Juxi-Technology/SR-Support/firmware/sr_support_b_ptk/README.md

# sr_support_b_ptk — B 线固件（PTK7452MG，180° PWM）

> **完整步骤请按教程 [`../../tutorial/zh-hans/03-build-flash.md`](../../tutorial/zh-hans/03-build-flash.md) 及后续页**。

> **客户直接烧固件**：用 [`../releases/sr_support_b_ptk_factory.bin`](../releases/sr_support_b_ptk_factory.bin)
> 烧到 `0x0` 即可，无需 PlatformIO；本 README 其余部分面向开发者。

> 当前主固件。基于 Juxi-Technology/2dof-selfrighting-robot B 线固件（MIT/Apache-2.0），已改为 **PTK7452MG + 无源直连转接板**。
> 来源/许可：[`../../third_party/juxi-2dof/`](../../third_party/juxi-2dof/) · 教程 [`../../tutorial/zh-hans/11-reference.md`](../../tutorial/zh-hans/11-reference.md)  
> 状态：**已编译并烧录**（PlatformIO 6.2.0 + espressif32 8.0.0 + Arduino core 3.3.12；RAM 7.6%，Flash 13.0%；COM27 烧录 Hash verified）；**IMU 0x23 与两路舵机 bring-up 通过（`t` 自检）**；机械臂尚未组装，策略未跑。首次上电先手扶、空载、低电压。

## 1. 硬件假设

- ESP32-S3-DevKitC-1（或兼容板）。
- 转接板：**无源直连**，ESP32 GPIO → 3-pin 舵机排针；舵机 V+/GND 共用电源轨，排针可级联；**没有 PCA9685 / GPIO 扩展**。
- 2× PTK7452MG（180° PWM，无位置反馈；v0 只用 2 个，其余备用）。
- Juxi 6 轴 IMU（I²C 0x23、100 kHz、3.3V）。
- 舵机电源：**5V/≥5A**（本项目实机，四方向扶正已验证；PTK7452 额定 6V 约 3.4 kg·cm，更高电压仅作余量且只能接舵机电源轨）。
- ESP32 由同一 5V 电源经一分二供电（或 USB-C）；与舵机电源 **共地**；舵机电源端 1000–2200 µF。

## 2. 接线（示例，按转接板实际丝印确认）

| 器件 | 引脚 | 说明 |
|---|---|---|
| IMU SDA | GPIO6 | I²C 100 kHz；转接板 S6 信号脚 |
| IMU SCL | GPIO7 | I²C 100 kHz；转接板 S7 信号脚 |
| IMU VCC | ESP32 3V3 | 经转接板 S1 信号脚；**不要接舵机 V+（5V）** |
| IMU GND | ESP32 GND（直连） | 共地 |
| 肩舵机信号 | GPIO4 | 转接板 S4，50Hz PWM |
| 肘舵机信号 | GPIO5 | 转接板 S5，50Hz PWM |
| LED（可选） | GPIO2 | 状态灯 |
| 舵机 V+ | 5V/5A 电源 + | **不要接 ESP32 3V3** |
| 舵机 GND | 电源 − / ESP32 GND | 共地 |

> 转接板是级联方式：确认每个排针的 V+/GND/信号顺序一致，避免插反。

## 3. 编译/烧录

> **工具结论：PlatformIO（Arduino framework），不是 ESP-IDF。** 底层是 `esptool`，PlatformIO 会自动调用；不需要 `idf.py`。  
> 本机已装 Core 6.2.0 到项目内 `.venv`（与电脑端工具共用）；先激活 `.venv`，再直接用 `pio ...`；首次使用运行 `powershell -ExecutionPolicy Bypass -File tools/install_platformio.ps1` 安装。

PlatformIO（推荐）：

```bash
pio run -d firmware/sr_support_b_ptk -t upload
pio device monitor --rts 0 --dtr 0 -b 115200
```

Arduino IDE：

- 打开 `firmware/sr_support_b_ptk/src/main.cpp` 不是有效的 Arduino sketch；本目录是 PlatformIO 结构。  
- 如果必须用 Arduino IDE，新建 sketch，把 `src/*` 和 `include/*` 放到 sketch 目录，确保 `config.h` 在 include 路径；`config.h` 已定义 `ROBOT_PWM`，不需要额外 build flag。
- LEDC API 已兼容 Arduino-ESP32 2.x/3.x。

## 4. 串口命令（115200）

| 命令 | 作用 |
|---|---|
| `g` | 开始/继续运行策略（上电默认保持） |
| `s` | 停止策略，PWM 保持最后目标（不释放力矩） |
| `x` | 急停：detach PWM（舵机卸力）；之后需 `r` 重新初始化 |
| `r` | 重新初始化 PWM、回中位；再发 `g` |
| `c` | 重新校准陀螺 + **加速度计零点**（机器人须**站立在水平桌面**、保持静止）；加速度零点写入 NVS，重启自动加载。躺姿姿态倾斜不收敛时先做这一步 |
| `t` | 关节 ±0.5 rad 自检；结束后恢复原状态 |
| `1` / `2` | 手动：肩关节 +0.5 / −0.5 rad（保持，便于看方向） |
| `3` / `4` | 手动：肘关节 +0.5 / −0.5 rad |
| `0` | 手动：两关节回中位（仍为 manual 保持） |
| `m q1 q2` | 手动：任意目标角（rad，换行结束），例如 `m 1.55 -1.55` |
| `a` | **脚本自动扶正**：检测到倒地（`up_z<0.5` 持续 0.5 s）后执行实测序列，站起后回中保持；`s` 停止 |
| `v` / `b` | 运行时翻转肩 / 肘方向符号（校准用，重启恢复默认） |
| `i` / `j` | 运行时翻转 IMU X / Y 轴符号（之后发 `c` 重新校准陀螺） |
| `l` | 输出 3 s、50 Hz 快速日志（`F` 行：up/gyro/q/state/原始 IMU）；配合 `tools/hw_log.py` |
| `d` | **MuJoCo 实时镜像**：开关 50 Hz `T` 流（`T w x y z q1 q2`，姿态四元数 + 指令关节角）；配合 `tools/live_twin.py` |
| `o` / `p` | 肩关节 PWM 中位微调 ±10 µs（≈±0.9°，运行时，重启恢复）；`k` 读出当前中位 |
| `z` | **编码器式清零**：手动摆到目测中位后发送，当前姿态即成为两关节 q=0，并打印新中位值（不进 flash，确认后写回 `config.h`） |
| `e` | **电气中位**：两舵机直接输出 1520 µs（装舵盘前找中位用，与当前零点无关；之后发 `m 0 0` 退出） |

> `1`–`4`/`0`/`m` 进入 manual 模式，50 Hz 按 0.12 rad/步限速；`s`/`r`/`g` 都会退出 manual。
> IMU 固定 100 Hz 读取；主循环不再无节流读 I²C（否则读取失败、姿态冻结，策略会抖）。

每 250 ms 输出：

```
up ux uy uz | w wx wy wz | q q1 q2 | qd dq1 dq2 | run/hold/manual
```

> `s` 只是停止策略，舵机仍可能堵转发热；长时间异常请 `x` 或直接断舵机电源。  
> `x` 后舵机卸力，手臂会因重力落下；确认安全后再用。

### 4.1 MuJoCo 实时镜像（live twin）

`d` 打开的 `T` 流每 20 ms 一行：`T <qw> <qx> <qy> <qz> <q1> <q2>`（原始 IMU 坐标系四元数 + 指令关节角）。电脑端：

```
python tools/live_twin.py --port COM27
```

工具会自动发一次 `d`（若已在输出 `T` 行则不发），把实机姿态和手臂实时映射到 `robot_v1.xml` 模型窗口里；无 `T` 流时回退到 4 Hz 状态行或 `l` 快速日志（无四元数，航向由 up 向量最短弧重建，方向可能任意）。`--replay <日志文件>` 可离线回放。注意打开串口可能触发 ESP32 复位（DTR）。

### 4.2 零点标定（`z` 命令 + 方向键工具）

换齿、拆装或更换舵机后，按以下步骤重新定零（会把"手臂竖直"变成固件的 q=0）：

1. 电池 + Type-C 都接上，运行：

   ```
   python tools/hw_shoulder_range.py
   ```

2. 用**方向键**摆臂：`↑`/`↓` = 大臂 ±0.05 rad，`←`/`→` = 小臂 ±0.05 rad（Shift+方向键 = ±0.20），
   摆到目测正中竖直；
3. 按 `z`：当前姿态成为两关节的 q=0，固件打印新的中位值（肩/肘 µs）；`k` 可随时读取中位；
4. 把这两个 µs 写回 `config.h`（`SERVO_SHOULDER_CENTER_US` / `SERVO_CENTER_US`），并把
   `EXEC_REF*` 与 `getup_reference_b39.py` 的全部路点按同样的差值平移，重新烧录；
5. 复测四个方向。

> `z` 只改内存，重启即恢复；确认好用后必须按第 4 步固化，否则扶正序列的物理姿态会漂移。

### 4.3 WiFi 状态页与无线镜像

热点：SSID `SR-Support`，密码 `srsupport`，ESP32 地址 `192.168.4.1`（`w` 命令开关，默认开）。

**Twin 流开关**：状态页底部 `Twin ON/OFF` 按钮 = 串口 `d` 命令，MuJoCo 镜像无需串口：

```
python tools/live_twin.py --tcp <Robot IP>:3333
```

**配网（让 ESP32 加入家里的 WiFi）**：连上 `SR-Support` 热点后多数手机会自动弹出配网页
（热点门户）；没有弹出就手动打开 `http://192.168.4.1`，在 **Home WiFi** 卡片点 `Scan` →
选网络 → 填密码 → `Connect`。成功后：ESP32 以 AP+STA 双模同时留在热点和你家路由器上，
状态页显示它在家里的 **Robot IP**；凭据写入 NVS，重启自动重连。扶正执行期间拒绝配网
（扫描会短暂中断热点）。仅支持 2.4 GHz 网络。

- **浏览器状态页**：设备连上热点后打开 `http://192.168.4.1`，每 300 ms 刷新：状态
  （hold/getup/manual）、up 向量与直立度条、两关节指令角、扶正姿态/阶段/换向次数、运行时长。
  注意端口 80 是 HTTP；旧的 3333 是原始 TCP 遥测流，浏览器直接打开会超时。若浏览器设置了
  系统代理，请把 `192.168.4.1` 加入代理例外或临时关闭代理。
- **MuJoCo 无线实时镜像**：无需串口，`d` 打开 T 流后：

  ```
  python tools/live_twin.py --tcp 192.168.4.1:3333
  ```

  电脑需先连上 `SR-Support` 热点（此时电脑一般无外网，GitHub 等操作会失败，属正常）。
- 有线串口只在烧录/导出日志时需要；日常遥测、镜像、状态页都可以纯 WiFi。

> 加入外部路由器（STA 模式）未实现：需要配网与重连逻辑，当前 AP 方案已覆盖离线使用场景。

## 5. 策略（重要）

- `include/policy_b.h` 现在是 **v7（SR 慢接口）策略**（`training/b_line/models/ppo_selfrising_sr5/final.zip` 导出，5 维观测、目标增量 0.08 rad/step，10→128→128→2，Tanh），按估算质量 97.4 g、硬舵机模型（kp=50/kv=0.5）训练。
- 固件内置**站立收臂**：`up_z>0.95` 连续 0.2 s → 目标角以 0.12 rad/20 ms 归零（手臂竖直）并保持；`up_z<0.95` 暂停收臂，`<0.90` 交回策略重试。
- PTK7452 额定 6V 3.4 kg·cm（本项目 5V 实测可四方向扶正）；实机打印件称重后，用 [`../../training/b_line/`](../../training/b_line/) 重训并重新导出覆盖 `policy_b.h`。**当前版本按估算质量训练，实机成功率会低于仿真。**
- 观测/动作必须一致：10 维 `[up(3), gyro(3), q(2), qdot(2)]`；目标角 = action × 1.55 rad；每 20ms 最多变化 0.12 rad。

## 6. 上电顺序（建议）

1. 机器人放桌面，手臂大致竖直，周围 30 cm 无遮挡；手扶底座。
2. 只接 USB，确认 IMU 版本、陀螺校准、`ready; send g to run`。
3. 舵机上电（5V/5A），确认无异常电流/发热。
4. 发 `t` 自检，确认两个关节方向；方向反了改 `SERVO_SHOULDER_SIGN`/`SERVO_ELBOW_SIGN` 或重装舵盘。
5. 手扶机器人摆成倒地姿态，发 `g`；一有异常立即 `x` 或断舵机电源。
6. 成功后再逐步放手；记录成功率、电流、温度。

## 7. 旧骨架的去向

旧 8 路骨架固件 `sr_support_2dof/` 与两套 `reference_*` 示例已随 2026-11 仓库瘦身移除。
B 线只用 2 路 PWM（肩/肘），不需要 PCA9685；若以后要做 8 舵机机构，按 `src/servo_pwm.cpp`
的 LEDC 后端扩展即可。

## 8. 许可

- 固件基于 Juxi B 线代码（MIT/Apache-2.0）；保留 `third_party/juxi-2dof/` 的许可/来源。
- 不链接 Feetech SCServo（GPL-3.0）；B 线固件可按 MIT/Apache 使用。
- 硬件若使用 Juxi B 线 CAD/STL，属于 CERN-OHL-S-2.0；商用/分发前确认义务。
- 不使用 SelfRisingRobot 的代码/waypoint；`policy_b.h` 仅作基线，最终策略由本项目重训。
