Juxi-Technology/SR-Support/tutorial/zh-hans/01-hardware-and-bom.md

---
title: 01 硬件与物料
description: SR-Support 自扶正装置的整机参数、BOM、工具清单与供电安全要求。
---

# 01 硬件与物料

## 1.1 整机概览

SR-Support 是 2-DOF（肩 + 肘）主动自扶正装置：倒地后依靠手臂撑地、翻转和撬起，自主回到直立。

| 项目 | 参数 |
|---|---|
| 底座 | 8.5 × 8.5 cm 方形；总高 4 cm（3.7 cm 灰色升高座 + 3 mm 红色底板） |
| 手臂 | 直立高度约 26 cm（上臂 + 前臂） |
| 整机质量 | 约 102 g（含两舵机与电控，待逐件称重校准） |
| 肩关节 | PTK7452MG，可用行程约 [-1.07, +2.07] rad（舵盘换齿重新定零后） |
| 肘关节 | PTK7452MG，可用行程约 ±1.55 rad |
| 主控 | ESP32-S3-DevKitC-1（Arduino framework / PlatformIO） |
| 姿态 | Juxi ICM42670P 6 轴 IMU（I²C 地址 0x23，100 kHz） |
| 舵机驱动 | ESP32 LEDC，50 Hz，14 bit，脉宽 500–2500 µs |

## 1.2 BOM

| 类别 | 物料 | 数量 | 说明 |
|---|---|---|---|
| 结构 | 3D 打印件 `footP` / `arm1P` / `arm2P` / `armhornP` | 1 / 1 / 1 / 2 | PETG 或 PLA；打印后逐件称重 |
| 执行 | PTK7452MG 180° PWM 舵机 | 2 | 金属齿、25T、约 12.2 g；6 V 约 3.4 kg·cm |
| 主控 | ESP32-S3-DevKitC-1 | 1 | USB-C |
| 转接 | 无源直连舵机转接板 | 1 | GPIO → 3-pin 排针；共用 V+/GND；无 PCA9685 |
| 传感 | Juxi ICM42670P IMU 模块 | 1 | 3.3 V 供电 |
| 电源 | 6 V / ≥5 A 舵机电源 | 1 | 独立供电 |
| 电源 | 电解电容 1000–2200 µF + 100 nF | 各 1 | 舵机电源端 |
| 电源 | 5 A 保险丝 / 自恢复保险丝 + 电源开关 | 1 组 | — |
| 线材 | USB-C 数据线、杜邦线、舵机延长线 | 若干 | — |
| 紧固 | M2/M3 螺丝、扎带、橡胶 O 圈 | 若干 | O 圈可做末端防滑 |

## 1.3 工具

- 卡尺、万用表（通断/电压档）；
- 十字螺丝刀、内六角；
- 电脑：PlatformIO（推荐）或 Arduino IDE；
- 选配：舵机测试仪、INA219 电流检测。

## 1.4 供电与安全

- 2× PTK7452MG 使用 **6 V / ≥5 A** 独立电源；7.4 V 可接近 4.5 kg·cm，但需实测发热/电流；
- 舵机电源端并联 1000–2200 µF 电解电容与 100 nF 陶瓷电容，串 5 A 保险丝，加电源开关；
- ESP32 用 USB-C 5 V 单独供电，与舵机电源**共地**；
- **不要把 6 V/7.4 V 接到 ESP32 的 5V/3V3**；不要用电脑 USB 口直接带两个舵机；
- 上电顺序：先接好共地与信号 → 舵机上电 → ESP32 上电；断电顺序相反。
