Juxi-Technology/SR-Support/hardware/v1/meshes/foot_servo_shoulder.stl

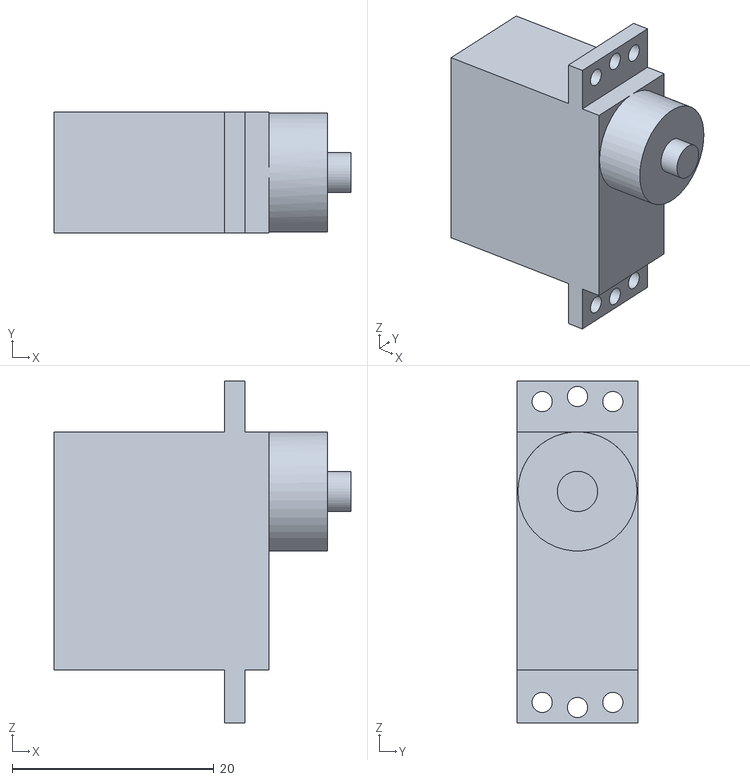
[picture p1: CAD file, 2026-10-30]
hardware/v1/meshes/foot_servo_shoulder.stl
29.4 x 12.0 x 33.9
