Juxi-Technology/SR-Support/hardware/v1/meshes/arm1_bracket.stl

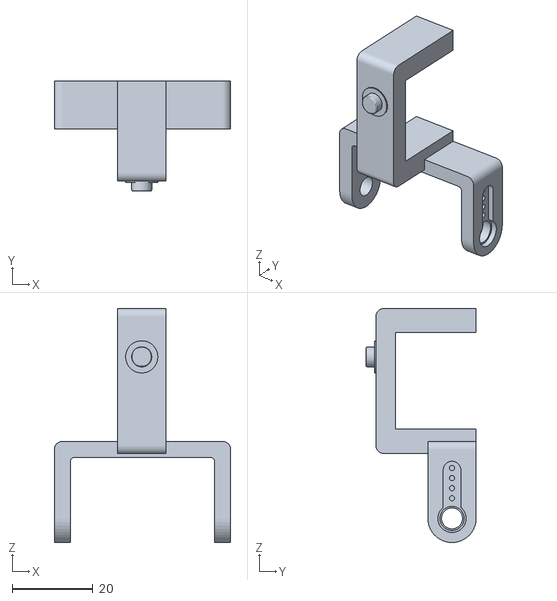
[picture p2: CAD file, 2026-10-30]
hardware/v1/meshes/arm1_bracket.stl
43.8 x 27.4 x 58.1
