Juxi-Technology/SR-Support/hardware/v1/meshes/foot_shell.stl

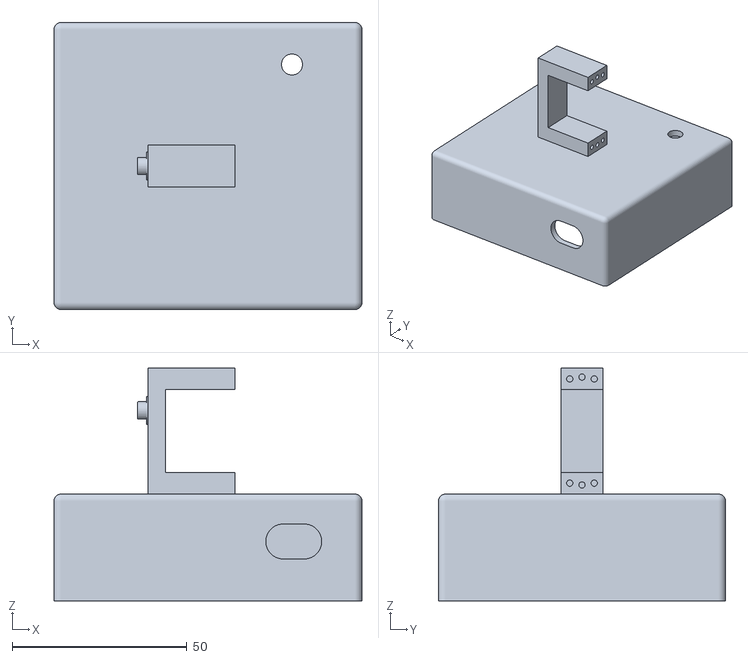
[picture p3: CAD file, 2026-10-30]
hardware/v1/meshes/foot_shell.stl
88.0 x 82.0 x 66.6
