Juxi-Technology/SR-Support/hardware/v1/meshes/foot_bottom.stl

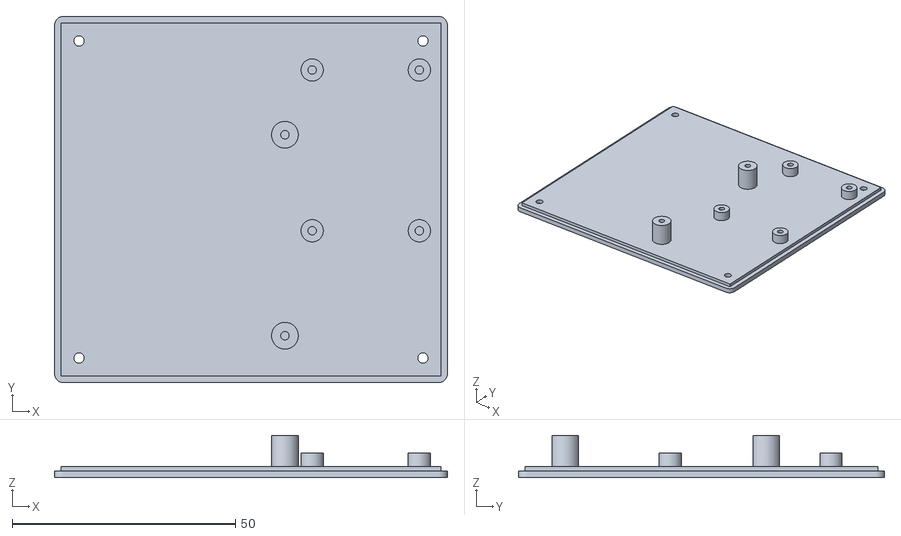
[picture p4: CAD file, 2026-10-30]
hardware/v1/meshes/foot_bottom.stl
88.0 x 82.0 x 9.50
