Juxi-Technology/SR-Support/hardware/v1/meshes/arm2_strut.stl

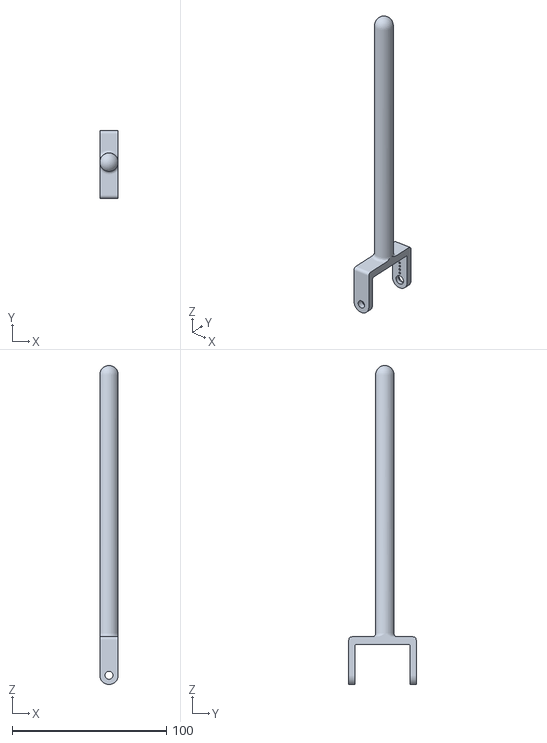
[picture p5: CAD file, 2026-10-30]
hardware/v1/meshes/arm2_strut.stl
12.0 x 43.8 x 207.0
