Juxi-Technology/SR-Support/(list of files, cad)

Other CAD files:
hardware/v1/meshes/arm1_servo_elbow.stl
