Juxi-Technology/SR-Support/tutorial/zh-hans/04-build-flash.md

---
title: 04 第一步：烧录主固件
description: 用预编译 bin（Flash Download Tool / esptool）或 PlatformIO 源码构建烧录 SR-Support B 线固件，串口命令与启动日志说明。
---

# 04 第一步：烧录主固件

> **成品用户可跳过本页**：出厂已烧录并验证固件。仅在升级固件或自行修改代码后执行。
> 客户直接烧预编译固件（4.1，不需要 PlatformIO）；开发者从源码构建（4.2）。

## 4.1 烧录预编译固件（推荐给客户）

1. 确认有 `firmware/releases/sr_support_b_ptk_factory.bin`（校验和见同目录
   `SHA256SUMS`；从 GitHub Releases 下载时需仓库权限）；
2. 进入下载模式：按住 **BOOT**，点按一下 **RST**，松开 **BOOT**；
3. 烧录（工具安装见 [02 页 2.3](./02-environment)；以下命令在 `SR-Support` 目录、
   已激活 `.venv` 的终端里执行）：
   - Windows 图形界面：Flash Download Tool → ESP32-S3 → `0x0` 加载 bin → START；
   - Windows / Linux / macOS 命令行：

     ```bash
     python -m esptool --chip esp32s3 -p COM27 -b 460800 write_flash 0x0 firmware/releases/sr_support_b_ptk_factory.bin
     ```

4. 烧录完成后按 RST 启动，按下节 4.3 查看日志。

> 装配找中不需要第二个固件：烧好本固件后串口发 `e`，两舵机输出 1520 µs
> （见 [03 页 3.2](./03-assembly)）。

## 4.2 从源码构建与烧录（开发者）

环境见 [02 页 2.5](./02-environment)。工程：`firmware/sr_support_b_ptk/`（环境名 `ptk7452`）。

```bash
# 构建
pio run -d firmware/sr_support_b_ptk

# 烧录（COM27 换成实际串口）
pio run -d firmware/sr_support_b_ptk -t upload --upload-port COM27
```

> 命令在 `SR-Support` 目录下、已激活 `.venv` 的终端里执行（02 页 2.3）。烧录前必须
> 关闭占用串口的程序（串口监视器、`tools/hw_monitor.py` 等），否则会报
> `could not open port` / `Access is denied`。

构建成功时资源占用约 RAM 56%、Flash 30%（含 WiFi 与网页服务；不含 WiFi 的早期版本
约 7%/12%）。

## 4.3 串口监视

```bash
pio device monitor --rts 0 --dtr 0 -b 115200 -p COM27
```

打开串口会触发 ESP32 复位；复位后应看到：

```text
IMU version 1.1.2
autorun on: get-up waits for a fall
up ... | w ... | q ... | qd ... | run
```

## 4.4 串口命令（115200）

| 命令 | 作用 |
|---|---|
| `g` | 开始/继续运行（本版本上电默认自动运行，一般不需要） |
| `s` | 停止执行器，PWM 保持最后目标 |
| `x` | 急停：释放 PWM（舵机卸力），之后需 `r` 重新初始化 |
| `r` | 重新初始化 PWM 并回中位 |
| `t` | 舵机自检（小幅动作） |
| `c` | 标定陀螺 + **加速度计零点**（机器人须**站立在水平桌面**、保持静止；零点写入 NVS） |
| `m <q1> <q2>` | 手动设置两关节目标角（rad） |
| `1/2` | 手动肩关节 ±0.5 rad |
| `3/4` | 手动肘关节 ±0.5 rad |
| `0` | 手动回中 |
| `l` | 3 秒 50 Hz 快速日志 |
| `k` | 打印两舵机中位脉宽 |
| `o` / `p` | 肩中位脉宽 ±10 µs 微调 |
| `z` | 编码器式清零：当前姿态设为两关节 q=0 并打印新脉宽（仅内存；见 [06 页](./06-zero-tool)） |
| `e` | 电气中位：两舵机输出 1520 µs（装配装舵盘用，与当前零点无关；见 [03 页 3.2](./03-assembly)） |
| `d` | 开关 50 Hz Twin 流（供 MuJoCo 镜像；状态页有同等开关） |
| `w` | 开/关 WiFi（热点 + 状态页/配网，见 [09 页](./09-wifi-twin)） |
| `v` / `b` | 翻转肩 / 肘方向符号 |
| `i` / `j` | 翻转 IMU X / Y 符号 |
| `h` | 站立收臂回中开关（旧策略用） |
| `a` | 旧的脚本扶正模式（legacy，仅测试用） |

## 4.5 上电行为

固件启用 `AUTORUN_ON_BOOT`：上电后执行器处于待命状态，等机器人**完全倒下且静止**
0.5 秒后自动开始扶正，无需发送 `g`。上电时请让机器人保持直立。
