Juxi-Technology/SR-Support/tutorial/zh-hans/02-assembly-and-wiring.md

---
title: 02 装配与接线
description: SR-Support 的打印件装配、舵机换齿与中位、接线表、IMU 安装方向与上电顺序。
---

# 02 装配与接线

## 2.1 打印与检查

1. 打印 `footP`、`arm1P`、`arm2P`、`armhornP` ×2；
2. 用卡尺核对底座外形约 60 × 73 mm、升高座高 37 mm；底板厚 3 mm，总高 40 mm；
3. 检查舵机安装槽与 25T 舵盘配合，无干涉后再上螺丝；
4. 打印件逐件称重并记录（用于后续仿真模型质量校准）。

## 2.2 舵机准备（换齿定零）

1. 上电前先把两只舵机分别发 1520 µs（中位）脉宽；
2. **肩舵机需要重新定零**：把舵盘相对花键错开约 2 齿（≈29°），使机械臂竖直时
   对应固件零位 `q=0`。换齿后用第 4.5 节的**方向键工具**把"目测中位"定义为 q=0，并把
   工具打印的脉宽写回 `SERVO_SHOULDER_CENTER_US`（当前整机固化值 **1681 µs**）；
3. 肘舵机零点同样以 4.5 节的定零结果为准（当前整机固化值 **1456 µs**，`SERVO_CENTER_US`）；
4. 装舵盘、拧紧，手动检查行程无卡滞；
5. 方向约定（与仿真一致）：`shoulder +q` 使大臂向 **−Y**，`elbow +q` 使小臂向 **+X**；
   固件默认 `SERVO_SHOULDER_SIGN=-1`、`SERVO_ELBOW_SIGN=-1`。

> 齿位决定两侧行程分配；固件手动限位（`Q_SHOULDER_MIN/MAX`）必须与实际行程一致，
> 不要随意放宽。定零后务必按 4.5 节把序列路点同步平移，否则扶正动作的物理姿态会漂移。

## 2.3 底座与手臂装配

1. 红色底板（3 mm）与灰色升高座（37 mm）用 M3 螺丝固定，组成 40 mm 高底座；
2. 肩舵机装入底座顶部舵机槽，舵盘朝上；
3. `arm1P`（上臂）安装在肩舵盘上，锁紧；
4. 肘舵机装入 `arm1P` 顶部，`armhornP` 连接 `arm2P`（前臂）；
5. 装配后手动把手臂摆到竖直（`q≈0`），确认与舵机中位一致。

## 2.4 接线

| 器件 | ESP32-S3 引脚 | 转接板 | 说明 |
|---|---|---|---|
| 肩舵机信号 | GPIO4 | CH1 | 50 Hz PWM |
| 肘舵机信号 | GPIO5 | CH2 | 50 Hz PWM |
| IMU SDA | GPIO6 | CH3 信号脚 | I²C 0x23，100 kHz |
| IMU SCL | GPIO7 | CH4 信号脚 | I²C 0x23，100 kHz |
| IMU VCC | 3V3 | — | **禁止接舵机 V+（6 V）** |
| IMU GND | GND | CH3/CH4 GND | 共地 |
| LED（可选） | GPIO2 | — | 状态灯 |
| 舵机 V+ | — | V+/GND 端子 | 6 V / ≥5 A |
| 舵机 GND | — | V+/GND 端子 | 与 ESP32 共地 |

注意事项：

- 转接板为无源直连：确认每个级联口的 V+/GND/信号顺序一致，插反会烧舵机或板子；
- I²C 线尽量短，不要与舵机线长距离并行；模块上拉一般为 3.3 V；
- 第一次上电先不接舵机，用万用表确认 V+ 电压与极性；再接一个舵机测试，最后接两个；
- 上电顺序：共地与信号 → 舵机电源 → ESP32 USB；断电相反。

## 2.5 IMU 安装方向

IMU 相对机体绕竖轴旋转了 +90° 安装。固件在 `config.h` 中启用 `IMU_YAW90`，
把 IMU 坐标系下的 up 向量换算到机体坐标：

```c
up_body = (up_imu.y, -up_imu.x, up_imu.z)
```

安装后请按第 04 章检查：直立时 `up≈(0, 0, 1)`；四种躺姿的 up 向量见 4.4 节表格。
