Juxi-Technology/SR-Support/tutorial/zh-hans/05-self-righting-usage.md

---
title: 05 自扶正使用
description: SR-Support 四个倒下方向的自扶正操作方法、预期动作时间、串口事件与监控日志。
---

# 05 自扶正使用

## 5.1 操作步骤

1. 上电时保持机器人直立，等待串口出现 `autorun on: get-up waits for a fall`；
2. 把机器人放倒（任意方向），**松手并保持静止约 0.5 秒**；
3. 串口出现 `getup start pose=<姿态>` 后开始自动扶正；
4. 扶正完成后串口出现 `standing -> executor done`，执行器回到待命；
5. 若 14 秒内未完成，串口出现 `executor timeout`，1.5 秒冷却后跌倒门会再次触发重试。

## 5.2 四个方向的预期过程

| 姿态 | 机制 | 实机用时 |
|---|---|---|
| `pitch_neg`（顶部朝 −X） | 肘部撑地 + 肩部回摆直接撬起 | ≈3 s |
| `pitch_pos`（顶部朝 +X） | 直接撬起；若收臂时翻向对侧，姿态重规划接 `pitch_pos` 再扶正 | ≈5–6 s |
| `roll_pos`（顶部朝 −Y） | 肩部大行程直接杠杆扶正 | ≈3 s |
| `roll_neg`（顶部朝 +Y） | **全行程直接按压 → 肘部楔形泵 ×2 → 必要时鞭甩下砸重试**；无需翻滚 | ≈2–6 s |

> 早期固件中 `roll_neg` 需要"滚过顶部 + 姿态重规划"（5–14 秒）；现版本已改为与 +Y 侧镜像的
> 直接按压机制，四方向动作对称、速度接近。若偶尔出现
> `executor re-plan roll_neg -> ...`，说明该次按压失败进入了兜底重试，属正常退路。

## 5.3 执行器逻辑（固件内）

- 每个参考路点 20 拍（0.4 s），线性插值；每拍输出限速 0.08 rad；
- 参考走完后以 0.033 rad/拍把手臂收回中立位；
- `up_z > 0.95` 且目标归零持续 50 拍 → 判定完成；
- 身体停在另一躺姿轴（`up_z<0.6`、`|ω|<0.8` 持续 15 拍）→ 中立回撤后切换新姿态参考，最多 5 次；
- `roll_neg` 参考带**分阶段自适应保持**：按压/泵阶段在 `up_z<0.92` 时保持（各阶段有上限拍数，
  按压 40 / 泵 30 / 泵 30 / 收尾 90 拍）；序列中途站起会立即跳到收臂阶段，避免站好后再被
  后续动作打倒。

## 5.4 监控与日志

```bash
.venv-pio/Scripts/python.exe tools/hw_monitor.py COM27
```

- 每秒读取串口，把事件与 5 秒遥测追加到 `logs/hw_monitor.log`；
- 自动记录事件：`getup start`、`executor re-plan`、`standing`、`executor timeout`、
  `IMU lost` 等；
- 自动检查舵机越界（肩 `[-1.07,+2.07]`、肘 `±1.55`），越界时写 `!! VIOLATION`；
- 执行器运行期间每 0.2 s 输出轨迹：

```text
executor pose=roll_neg ph=3 tick=9 tgt=(2.00,-0.80) up=(0.58,-0.24,-0.77) q=(2.00,-0.80) sw=0
```

| 字段 | 含义 |
|---|---|
| `pose` | 当前参考姿态 |
| `ph` / `tick` | 当前路点相位 / 相位内拍数 |
| `tgt` | 目标关节角 |
| `up` | 当前 up 向量 |
| `q` | 当前关节指令 |
| `sw` | 已发生的姿态切换次数 |

> 监控程序打开串口会复位 ESP32；烧录前必须先关闭监控。

## 5.5 记录与复测

建议每次测试记录：姿态、是否 `done`、用时、切换次数、是否有越界。日志文件即为记录，
可直接用 `logs/hw_monitor.log` 的时间戳检索。

## 5.6 WiFi：状态页、配网与无线镜像

热点：SSID `SR-Support`，密码 `srsupport`，地址 `192.168.4.1`（`w` 开关，上电默认开）。

- **状态页**：设备连上热点后打开 `http://192.168.4.1`（多数手机会自动弹出配网门户）。
  页面每 300 ms 刷新：运行状态、up 向量与直立度条、两关节指令角、扶正姿态/阶段、Home WiFi
  状态、Twin 流开关。浏览器有系统代理时，把该地址加入代理例外。
- **配网（加入家里的 WiFi）**：状态页 Home WiFi 卡片 `Scan` → 选网络 → 输密码 → `Connect`。
  成功后 AP+STA 双模：热点保留，家里局域网同时可访问（页面 `Robot IP` 显示地址）；凭据写入
  NVS，重启自动重连。仅支持 2.4 GHz；扶正动作执行期间会拒绝扫描/配网。
- **MuJoCo 无线实时镜像**：状态页按 `Twin ON`（等价串口 `d`），然后：

  ```bash
  .venv/Scripts/python.exe tools/live_twin.py --tcp <Robot IP>:3333
  ```

  窗口中的模型按实机姿态实时显示；手臂接触地面时会被"挡住"在接触角，模拟实机堵转。
  有线串口只在烧录和导出日志时需要。WiFi 遥测也可用
  `.venv/Scripts/python.exe tools/tcp_log.py` 落盘。
