Juxi-Technology/SR-Support/(commit log)

2026-10-28 Initial commit: SR-Support B-line self-righting robot (firmware, training, docs, tutorial)
    [b_arm1.step, b_arm1.stl, b_arm2.step, b_arm2.stl, b_assembly.step, b_base.step, b_base.stl, bom.csv]
2026-10-30 Single-side roll_neg get-up, live MuJoCo twin, physical lying poses
    Firmware (sr_support_b_ptk):
    - roll_neg is now the 180-deg mirror of the roll_pos press: shoulder to the
    -1.07 stop, elbow +0.8, hold ~1.6 s, retract. The arm levers the lying body
    straight up with no over-the-top roll. Hardware-verified: upright ~0.8 s
    after the press starts, ~3.5 s total; all four directions now get up.
    The old over-the-top recipe stalled at a 150-deg equilibrium because the
    PWM output is clamped (500-2500 us, shoulder centred at 1840 us), so the
    real shoulder travel is about [-1.07, +1.04] rad, not [-1.07, +2.07].
    - 'd' command: 50 Hz 'T w x y z q1 q2' telemetry stream for the live twin.
    Simu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
    [live_twin.py, main.cpp, play_getup_executor.py, search_v1_roll_neg.py]
2026-10-30 Publish the v1 CAD model and meshes (own design, CERN-OHL-S-2.0)
    The v1 MuJoCo model (robot_v1.xml, the +-1.57 and 270-deg shoulder
    variants) and its STL meshes are our own design, converted from the
    project's FreeCAD/STEP parts - no third-party geometry. They are now
    tracked and distributed under the hardware license CERN-OHL-S-2.0.
    The SelfRisingRobot-derived assets remain excluded.
    [arm1_bracket.stl, arm1_servo_elbow.stl, arm2_strut.stl, foot_bottom.stl, foot_servo_shoulder.stl, foot_shell.stl]
2026-11-02 Adaptive -X press, offline telemetry (ring + flash snapshot), WiFi live stream
    Firmware:
    - roll_neg press now holds until the body is upright (up_z >= 0.92) or the
    executor timeout (14 s) instead of a fixed 1.6 s hold. Hardware-verified
    on independent power: -X stands ~1.2 s after the press starts.
    - Compact 50 Hz telemetry 'S' lines (pose/phase/target/up/cmd/quat) into a
    128 KB RAM ring ('L' dumps it) and optionally over a WiFi AP
    ('SR-Support', TCP 3333, on after boot, 'w' toggles).
    - Each finished get-up (done/timeout) snapshots the ring to the unused
    spiffs flash partition; 'P' dumps it after a reset, so a battery-only
    test survives the USB-connect reset.
    - Log dumps feed the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
    [config.h, live_twin.py, main.cpp, tcp_log.py]
2026-11-03 roll_neg get-up: slam + adaptive press + elbow-wedge pump for 5V rail
    The 5V servo rail stalls the shoulder-only mirror press at up_z ~0.60
    (the static press is torque-marginal near the base-rim lever; it worked
    on the 6V bench). A kinematic probe of the recorded stall attitude shows
    extending the elbow drives the forearm tip deeper toward the floor and
    lengthens the contact lever with zero shoulder reaction, so the
    sequence now pumps elbow wedges at the shoulder stop, with capped
    adaptive holds that hand over between mechanisms and a mid-sequence
    upright exit. A lift-and-slam wind-up starts the press with an impact;
    re-winding between presses was rejected (it pushes the body back down).
    Pyt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
    [main.cpp, probe_v1_kick_geometry.py]
2026-11-03 roll_neg: press to -1.45 (Q_SHOULDER_MIN was not a measured stop)
    First hardware run of the wedge sequence (flash snapshot 2026-11-03):
    the sequence executes as designed and the elbow wedges add a repeatable
    +0.05 up_z at the press stall (0.60 -> 0.65), but the body still creeps
    up during the press hold - the plateau is torque-marginal, not
    kinematic. The configured shoulder minimum -1.07 has no measured
    mechanical stop behind it: PWM headroom reaches -2.10 rad and the model
    shows no arm/body self-collision down to -1.6. Deepen the press and
    wedge targets to -1.45; if a stop does exist the servo stalls on it
    exactly as before. Manual limit follows to -1.6.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
    [config.h, main.cpp]
2026-11-03 roll_neg: whip-slam strike, press targets back to -1.07
    Second hardware round: the servo on this side is load-saturated - it
    tracks only ~30 deg of the 115 deg commanded sweep (user observation),
    and deepening the press target to -1.45 changed the plateau by nothing,
    so extra commanded travel only strains the joint. Targets return to
    -1.07; the impact does the work: tuck the elbow to 1.2 in the air and
    drive shoulder + elbow down together so the extension lands at floor
    contact (~35% more impact energy), followed by the usual press hold and
    elbow-wedge pumps. If this still misses the balance line the remaining
    gap is mass/voltage: center the battery (or move it to the up-facing
    side of the -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
2026-11-03 roll_neg: direct full-travel press first, whip-slam becomes stage 2
    The operator wants the -X motion to open like roll_pos - one direct
    sweep toward the press side - instead of the slam wind-up swinging +X
    first. The live shoulder sweep (logs/shoulder_limit_sweep.txt) shows
    the joint accepts -1.6 on command; stage 1 now presses directly to
    -1.55 with the mirrored elbow fold, holds, and runs two elbow-wedge
    pumps. Only if that fails does stage 2 run the wind-up + whip-slam
    retry. The whip-slam round got up once out of three on 5 V, so the
    impact mechanism works but needs the retry budget.
    [main.cpp]
2026-11-03 roll_neg: slow the press to ~1 rad/s (torque-speed tradeoff)
    The operator noticed the running motion never shows the full sweep from
    the live limit test. The commands do reach -1.55 every cycle - the arm
    cannot follow because the executor slew is 4 rad/s, where this analog
    servo keeps only ~40% of its stall torque, while the manual sweep they
    watched ran at ~0.15 rad/s (near-stall torque). Split the direct press
    into 4 sub-steps (~1 rad/s net) and the elbow wedges into 2 sub-steps
    each; the whip-slam stays at full speed since it relies on momentum.
    Last round's log also shows the slam peaks at up_z 0.78 (highest yet)
    before sagging to 0.64.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
    [main.cpp]
2026-11-03 Add interactive shoulder travel recorder (operator-driven)
    The operator drives the shoulder step by step from a terminal prompt,
    watches the arm, and marks each physical end; the tool records the
    marked angles plus the 4 Hz IMU status lines to
    logs/shoulder_range_session.txt. The marked values feed back into the
    roll_neg press targets.
2026-11-03 Add encoder-style zero ('z'), document live center trim
    Operator request: like zeroing a magnetic encoder, jog the arm to the
    visual center pose and declare it q = 0. 'z' sets both PWM centers from
    the current command (refused while the executor runs) and prints the
    new values so they can be baked into config.h. The interactive range
    tool forwards z/k too. Also records the re-gear milestone: all four
    get-up directions now succeed on hardware.
2026-11-03 Range tool: show both joints, echo firmware replies
2026-11-03 Bake the operator visual-center zero and shift every sequence
    The operator zeroed with 'z': shoulder 1681 us (= +0.25 rad of the old
    frame), elbow 1456 us (= +0.10 rad). Bake both into config.h so q = 0
    holds the visually centered arm, and shift every waypoint and manual
    limit by -0.25 / -0.10 so the physical get-up poses stay identical to
    the verified all-directions run (press clamps land on the same points).
2026-11-03 roll_neg: restore the full-speed opening press like roll_pos
    The 4-substep slow press was added on a torque-speed hypothesis that
    hardware later disproved (the loaded horn barely rotates either way).
    The operator notices the -X opening visibly lags the +X side, so the
    press is back to a single 20-tick full-slew waypoint; wedge pumps and
    the whip-slam retry are unchanged.
2026-11-03 Zeroing tool: arrow-key control (up/down big arm, left/right small arm)
    Operator request: drive the zeroing pose with arrow keys instead of
    typed commands. msvcrt raw keys with a repeat gap; Shift+arrow = big
    step; typed-command fallback on non-Windows terminals. README gains the
    4.2 zeroing procedure.
2026-11-03 Zeroing tool: in-place display, snappy arrows
    Persistent 3-line block (key help, elbow, shoulder) rewritten with ANSI
    escapes instead of scrolling log lines; arrow moves pump only 60 ms and
    the repeat gap drops to 70 ms, so held keys jog smoothly. Firmware
    replies (z/k) print above the block. Console spam gone; the session
    file still records everything.
    [hw_shoulder_range.py]
2026-11-03 Zeroing tool: kill the remaining console spam
    Surface only the zero/center confirmations (the manual-target echo per
    move stays in the session log); shorten the help line so it cannot
    wrap and break the in-place block arithmetic on narrow terminals.
    [hw_shoulder_range.py]
2026-11-03 Zeroing tool: English UI, 4-line block
    Two short English help lines (the terminal is too narrow for one) plus
    the SmallArm/BigArm value lines; cursor math follows the new block
    height.
    [hw_shoulder_range.py]
2026-11-03 Zeroing tool: clearer help line (z=SetCenter), drop m from help
    The m key is only a log bookmark; it confused the zeroing flow.
2026-11-03 WiFi web status page on the access point
    Serve a self-contained status page at http://192.168.4.1: state,
    up-vector bar, joint angles, get-up pose/phase/switches, uptime,
    polled from /data as JSON every 300 ms. The existing 3333 raw TCP
    stream stays for the MuJoCo twin (tools/live_twin.py --tcp); the
    browser needs HTTP, which is why port 3333 timed out. README 4.3.
2026-11-03 Live twin: clamp the arm toward neutral instead of giving up on penetration
    Tipping the robot with the arm posed drove the model forearm up to 9 cm
    through the floor: the old one-way clamp bailed out whenever the arm was
    already under the floor after an orientation jump. The displayed arm is
    now the command scaled toward neutral until it just clears the floor
    (what the real stalled servo does); if even neutral digs in (the model
    forearm is a few mm deeper than the hardware), the body floats by the
    residual. Replaying the 535 recorded frames: worst penetration -91 mm
    -> -2 mm, median float 1.3 mm.
    [live_twin.py]
2026-11-03 Live twin: climb the arm to the floor-contact pose; no whole-body lift
    When even a neutral arm digs in (arm-side-down lying attitudes), the
    displayed arm now walks along the penetration gradient to the closest
    pose that just clears the floor - the contact angle the floor forces on
    the real arm - instead of floating the whole body, which showed up as
    the chassis hovering. Sweep of all 576 sampled lying attitude/command
    combinations: zero residual lift, penetration <= 2 mm.
2026-11-03 IMU: calibrate and persist the accelerometer zero offsets
    Lying poses froze ~9 deg off the true attitude: a raw accel offset makes
    the accel norm attitude-dependent, and in some lying attitudes it leaves
    the Mahony trust band, so the update is skipped and the attitude stays
    at the gyro-integration residual - the tilted-base twin misbehaviour.
    'c' now also averages the accel (robot must STAND LEVEL) and stores the
    offsets in NVS (namespace imu), subtracted in raw_to_si; boot loads them
    and hints when uncalibrated. Also fixes the long-standing standing tilt
    of ~1-2 deg from the same offsets.
    [main.cpp]
2026-11-03 IMU calibration: pace the sampler at 100 Hz and sanity-check the result
    Hammering the I2C bus at several hundred Hz returns corrupted reads
    (every axis' mean shrinks 5-6x), which poisoned the first accel bias
    (-7.85 m/s^2) and pushed the accel norm out of the Mahony trust band -
    the filter stayed gyro-only. Calibrate at the normal 100 Hz pace and
    reject means whose norm is not within 1.5 m/s^2 of gravity. Verified on
    hardware: bias now (-0.06, -0.08, -0.17) m/s^2, accel correction live.
    [main.cpp]
2026-11-03 docs: tutorial v1.1 - zero calibration manual and WiFi sections
    build-guide gains §9.6 (arrow-key zeroing: jog to the visual center,
    'z', bake the printed centers into config.h and shift the waypoints) and
    §9.7 (hotspot status page, home-WiFi provisioning, wireless MuJoCo twin,
    accel-bias calibration with 'c' standing level). Flow, appendix command
    table, changelog and the one-page checklist are updated to match.
2026-11-06 tutorial: sync zh-hans/en with the 2026-11 zeroing, WiFi and roll_neg changes
    - 02: horn zero now defined by the 4.5 arrow-key procedure (baked values
    1681/1456 us); warning block points at the waypoint shift.
    - 03: resources updated; command table gains z/d/w and the new c semantics.
    - 04: 'c' calibrates gyro + accel (stand level); lying-attitude check;
    centers/limits updated; new 4.5 zero-calibration manual.
    - 05: roll_neg is now a direct press + wedge pumps + whip-slam retry
    (~2-6 s, no roll-over); adaptive per-stage holds documented; new 5.6
    covering the status page, home-WiFi provisioning and the wireless twin.
    - 06: new rows for accel calibration, zero drift, post-getup chatter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
2026-11-06 tutorial: reorder into the SO-ARM-style reading flow (11 pages)
    Restructure after the Feishu SO-ARM101 tutorial layout: directory index
    -> basics -> standalone tool page (zero calibration, skippable) ->
    debug/checks page -> assembly -> Step 1 build/flash -> Step 2 calibration
    -> Step 3 self-righting -> Step 4 WiFi/twin -> troubleshooting ->
    reference (model files, parameters, sequences, licensing). Content is the
    current 2026-11 material re-grouped, zh-hans and en in lockstep; old
    chapter files removed.
2026-11-06 tutorial: state the factory-calibrated/tested condition and add skip paths
    Finished units ship assembled, flashed, calibrated (servo zeros + IMU
    accel zeros baked per unit) and tested (four directions verified). The
    index gains a 'factory state - two reading paths' table (finished-unit
    vs kit/DIY) plus a recommended first-use check; pages 02-07 carry
    explicit skip/dependency banners accordingly, and 10.4 lists the
    factory inspection items. zh-hans and en in lockstep.
2026-11-06 Slim the repo: single current model, no legacy lines, docs reorganized
    Deletions: bom/ (user keeps the BOM privately); hardware/juxi_b_line CAD
    (old external design, licensing relief); the old SelfRisingRobot-era
    training line and its PPO stack (selfright_env/train/evaluate/play/
    pretrain/stand_homer/export_policy - they only referenced now-deleted
    models; executor firmware is the product); old firmware skeletons
    (sr_support_2dof + reference_* sketches); ~25 one-off diagnostic/search
    tools; obsolete model variants (robot_ptk7452, robot_v1_sym/_270,
    sr_2dof) and simulation snapshots; the stray build_selfrising_model
    generator.
    Model home: the current model now lives at hardware/v1/ (robot_v1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
    [arm1_bracket.stl, arm1_servo_elbow.stl, arm2_strut.stl, b_arm1.step, b_arm1.stl, b_arm2.step, b_arm2.stl, b_assembly.step]
2026-11-06 tutorial: move servo zeroing after assembly+flash in the DIY path
    - DIY path is now 01 -> 04 -> 05 -> 02 -> 06 -> 07, and both zeroing and
    IMU calibration are stated to happen after full assembly and flashing
    - 04.2 separates the electrical center (servo_center_ptk, 1520 us) from
    the coarse horn index; the precise zero uses the page-02 tool later
    - 06.3 tells DIY builders to verify with k instead of re-zeroing
    - servo_center.py no longer claims 1520 us ('r' uses the baked centers)
    [servo_center.py]
2026-11-06 tutorial: make page 02 mandatory for DIY builds
    - retitle 02 from "skippable" to "required for DIY builds"; it is only
    skippable for factory-calibrated units
    - explain that a robot assembled without the 1520 us pre-centering can
    still be zeroed with z in any pose or horn index, since z only records
    the current servo command position; the horn index still fixes the
    travel split, so an out-of-range side needs a physical re-index
    - cross-updates in the index tables, the 04 assembly note, 06.3 and the
    tutorial README
2026-11-06 tutorial: put environment setup first and reorder into the real flow
    - add page 02 Environment setup (code, PlatformIO, tool venv, USB port)
    and move the environment content out of the build/flash page
    - renumber the pages into the actual operation order: basics, environment,
    assembly, build/flash, debug, zero, calibrate, usage, WiFi/twin,
    troubleshooting, reference; all cross-links and section numbers updated
    - assembly now gives the exact command to flash servo_center_ptk, which is
    now a proper PlatformIO project (build verified locally)
    - installers fall back to py -3 when Python 3.12 is missing
    [servo_center_ptk.ino]
2026-11-06 firmware: ship prebuilt factory images and make flashing tool-first
    - add firmware/releases: merged factory images for the main firmware and the
    servo-centering bench build (both flash at 0x0), SHA256SUMS and notes
    - add a tag-triggered GitHub Actions workflow that rebuilds and attaches the
    same-named assets to a Release, so tutorial links stay stable
    - tutorial 02/03/04: customers flash the prebuilt bin with Espressif Flash
    Download Tool (Windows) or esptool (Windows/Linux/macOS); PlatformIO is now
    the developer-only path, noting that its ~1 GB toolchain download often
    needs a proxy in China and that the VS Code extension does not avoid it
    - fix remaining links to the deleted docs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
2026-11-06 firmware: one bin does everything - add the e (electrical center) command
    - main firmware gains 'e': both servos output 1520 us regardless of the
    baked zero, so the horns can be installed before zeroing; no separate
    bench firmware/image is needed any more
    - releases now ship a single merged image (bootloader/partitions/boot_app0/
    app, flash at 0x0); drop servo_center_ptk.bin and its CI step
    - assembly page uses the main image plus 'e' (wire the IMU first - the
    firmware needs it to boot); serial command tables updated
    - servo_center_ptk stays in the tree as a reference sketch
2026-11-06 tutorial: update 01 basics to the v1 BOM and drop 1.4/1.5
    - BOM now lists the four printed v1 parts (bottom plate, shoulder mount,
    elbow mount, top strut), 2 servos, ESP32-S3, IMU, adapter, fasteners,
    wiring and the servo supply; the old footP/arm1P/arm2P/armhornP naming
    and the capacitor/fuse/switch rows are gone
    - overview matches hardware/v1: ~88x82x68 mm base, model masses (~133 g),
    firmware manual limits and the sim joint range
    - delete sections 1.4 Tools and 1.5 Power and safety per request
    - align the assembly page part names/dimensions and the index prerequisite
    line with the same v1 model
2026-11-06 tutorial: drop the fasteners row from the BOM
2026-11-06 tools: verify the environment by running it, not by importing modules
    - add tools/env_check.py: loads and steps the robot model in MuJoCo, checks
    the simulation state is finite, lists serial ports, prints PASS/FAIL
    - tutorial 02 now uses this functional self-test instead of the import
    one-liner and the --help check; the checklist matches
    - tutorial 05 documents tools/hw_check.py for a real serial round-trip and
    IMU tilt check on hardware
    [env_check.py]
2026-11-06 tutorial: explain the two ways to use the .venv consistently
    The page mixed explicit interpreter paths with the activated-venv style,
    which looked inconsistent. It now states that the tutorial uses explicit
    paths by default (copy-paste safe, avoids PowerShell blocking Activate.ps1)
    and shows how to switch to activation (python/pip) if preferred.
2026-11-06 docs/tools: standardize on one activated .venv for all Python/pio commands
    - page 02 now creates and activates a single project .venv; every later
    command is plain python / pip / pio in that activated terminal
    - install_platformio.ps1 installs PlatformIO into the same .venv instead of
    a separate .venv-pio; both installers print the activation step
    - tool docstrings and READMEs updated from .venv/Scripts/python.exe and
    .venv-pio/Scripts/pio.exe to the activated form
    - assembly/tutorial pages note the activation requirement
2026-11-06 tutorial: explain the venv activation script and per-shell variants
    Beginners had not seen .\.venv\Scripts\Activate.ps1. Page 02 now explains
    that it is the PowerShell activation script (the leading .\ is required),
    and lists the cmd.exe, Git Bash and deactivate equivalents.
2026-11-06 tutorial: add the cmd.exe commands and explain the cd /d behaviour
    On Windows cmd, `cd D:\...` only changes the current folder on D: and leaves
    the prompt on C:, so the tutorial's PowerShell example confused cmd users.
    Page 02 now has a cmd block (cd /d, activate.bat), explains how to tell cmd
    from PowerShell, and notes that administrator rights are not needed.
2026-11-06 tutorial: warn that the activation file must match the shell
    Running Activate.ps1 from cmd does not activate the current window. Page 02
    now says cmd uses activate.bat, PowerShell uses Activate.ps1, and reminds
    the reader to create .venv first (dir must list it).
2026-11-06 tutorial: explain the cmd screen redraw when activating the venv
    venv's activate.bat switches the console code page to UTF-8 and back; some
    terminals redraw/clear on chcp, which looks like a fresh terminal. Page 02
    now explains this, gives where/which as the activation check, and points to
    Activate.ps1 or the explicit interpreter as ways to avoid the redraw.
2026-11-06 tutorial: flash before assembly and fix the remaining audit findings
    - swap pages 03/04: the assembly centering step uses the main firmware's
    e command, so flash the firmware (03) before assembly (04); drop the
    step labels from titles and update every link/section reference
    - correct the 02 subsection refs (tool setup is 2.4, venv 2.3) and remove
    the leftover GitHub Releases mention on page 03
    - fix BOM/assembly part names (4 printed parts), 40 mm -> 68 mm, the k
    output format, m 0 0.5, the 4-line zero-tool UI, roll_neg hold caps, the
    monitor wording, the page 11 reference and the reference table layout
    - README and tutorial tree updated for the new order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
2026-11-06 tutorial: fix the last English cross-reference after the page swap
    The assembly page still pointed at section 3.4 for the wiring table; with
    assembly now page 04 the table is 4.4.
2026-11-06 tutorial: install the horns at the firmware zero (the actual build workflow)
    The builder wires everything, powers up and lets the servos move to the
    firmware zero, powers off and then assembles. Page 04 now documents that
    method; the baked centers already contain the horn re-index, so counting
    teeth or sending e is optional. The e command is marked optional and the
    zero page wording matches.
2026-11-06 tutorial: update the wiring table to the actual S1-S7 adapter harness
    - S1 carries 3V3 to the IMU VCC, S4/S5 the servo signals, S6/S7 the IMU
    SDA/SCL; S2/S3 stay empty; the IMU ground goes directly to the ESP32
    - a 5 V supply feeds the ESP32 5V/GND and branches to the adapter V+/GND
    for the servos; 6 V/7.4 V must feed the adapter only
    - index safety note clarified for the 5 V case
2026-11-06 tutorial: note USB + 5 V supply coexistence on the DevKitC
2026-11-06 tutorial: record that 5 V / 5 A is verified for all four directions
2026-11-06 docs: standardize the power spec to 5 V / >=5 A
    The build runs from a single 5 V supply that feeds the ESP32 5V pin and,
    through the 1-to-2 cable, the adapter servo rail; all four get-up
    directions are verified on that setup. Basics BOM, index prerequisites and
    safety, the assembly wiring table/notes, the root README and the firmware
    README no longer present 5-6 V or 6 V as the standard; 6 V/7.4 V remain
    only as a safety caveat (servo rail only). The firmware README wiring table
    also uses the actual S1-S7 adapter channels.
2026-11-06 tutorial: add the mechanical IMU/servo orientation check
    Describe the geometry in terms a builder can see: the shoulder servo
    output shaft (the shaft the horn mounts on) points toward the IMU -Y, the
    elbow shaft toward the IMU +X. These are the body shoulder/elbow axes
    implied by the IMU_YAW90 mapping. Page 04 defines the term output shaft
    and page 05 references the check before the up-vector test.
2026-11-06 tutorial: state that the servos are shoulder (lower) then elbow (upper)
2026-11-06 tutorial: clarify that page 05 is the whole-robot bring-up check
    Page 05 was easy to mistake for IMU-only debugging. It now opens with its
    scope (telemetry, IMU, servos, lying poses/fall gate) and points to page 07
    for the formal calibration procedure; the index row matches.
2026-11-06 tutorial: merge the debug and calibration pages into one actionable page
    Page 05 (debug) and page 07 (calibration) duplicated each other: 05 was
    mostly reference text and pointed at 07 for the actual steps. They are now
    one actionable page 06 "Debug and calibration" (telemetry, IMU, servos,
    center check, lying poses/fall gate, done criteria). Zeroing moves to page
    05, so the order is flash -> assemble -> zero -> calibrate -> use; pages
    07-10 renumber accordingly. All links, section numbers, index, READMEs,
    LICENSE and model comments were updated.
2026-11-06 tutorial: spell out the two power setups used while debugging
    During flashing, serial monitoring and calibration the builder may either
    keep the 5 V splitter feeding both the ESP32 and the servos (USB data only)
    or unplug the ESP32 branch and power the board from USB while the 5 V
    supply feeds only the servos. Both are normal; the second is what the
    builder used and is easier to reason about. Page 04 lists both, page 03
    mentions the flashing case and page 06 notes which commands need servo
    power.
2026-11-06 tutorial: confirm battery + Type-C can be connected together on the DevKitC
2026-11-06 tools: add a fixed-line live serial dashboard
    pio device monitor scrolls one telemetry line every 250 ms, which is hard
    to read during calibration. tools/hw_watch.py redraws a fixed block (up
    and tilt, gyro, joint angles, mode, last event) and forwards commands
    typed at cmd>, so the port is not tied up by a separate monitor; events go
    to logs/hw_watch.log. Page 06.1 presents both options: the fixed window for
    interactive checks, the raw monitor/hw_monitor for logs and full runs.
    [hw_watch.py]
2026-11-06 tools: keep the live dashboard block narrow enough not to wrap
    The first header line was wider than the terminal, wrapped onto a second
    display row and broke the fixed-row redraw (the header repeated down the
    screen). Lines are now short and clamped to the terminal width, and the
    event text is truncated from the end so the timestamp stays visible.
    [hw_watch.py]
2026-11-06 tutorial: explain how to read the up/w/q fields
    The page listed the telemetry fields but not their practical meaning. The
    table now says what normal values look like (upright up=(0,0,1), tilt=0,
    still w≈0, q=0 arm vertical) and includes example dashboard readings.
2026-11-06 tutorial: rewrite 6.2 as what c does, how to run it and how to judge it
    State that c averages 200 still samples (~2 s) for the gyro zero and the
    accel gravity vector, stores the accel part in NVS, what success looks like
    (gyro bias / accel bias saved), what accel cal rejected means, and how to
    verify afterwards. Note that c only touches the IMU, not the servo zero.
2026-11-06 tutorial: show calibration done; hold and how to resume after c
    c ends with "calibration done; hold"; if the robot was in manual mode the
    telemetry stays in manual and the fall gate does not arm. Note that and the
    g/reset recovery in 6.2.
2026-11-06 tutorial: point Windows users to the official UartAssist download
    Add the official 野人家园 page/download endpoint for UartAssist 5.15 and
    the COM settings (115200 8N1, no flow control, send newline), with a note
    to download only from the official link and not to commit the exe. macOS
    and Linux users keep using pio monitor or hw_watch.
2026-11-06 tutorial: put the UartAssist download link at the first serial use
    The first place a serial view is needed is page 03.3 (serial monitor),
    so the official UartAssist page/download and COM settings now live there;
    page 06.1 points back to it instead of repeating the link.
2026-11-06 tutorial: link every serial-using page back to the page-03 download
    Pages 04, 05, 06, 07, 08 and 09 now point to page 03.3 wherever they need
    a serial view/commands, so the UartAssist download and COM settings are one
    click away. The duplicate UartAssist paragraph on page 06 was removed.
2026-11-06 tutorial: list Linux/macOS serial viewers next to the Windows one
    pio device monitor remains the default; miniterm/screen are zero-install
    CLI options and CoolTerm/CuteCom the GUI options, with the dialout note
    for Linux.
2026-11-06 tutorial: restore the mechanical IMU check and fix the reset wording
    6.2 lost the pointer to the mechanical orientation check when it was
    rewritten; it is back as step 1. The monitor commands use --rts 0 --dtr 0,
    which do not intentionally reset the board, so the pages now say to press
    RST if the boot log is missing instead of promising a reset.
2026-11-06 tutorial/tools: align the monitor envelope and the base part names
    hw_monitor still used the old deployment range [-1.07, +2.07] while the
    firmware manual limits are [-1.85, +1.82]; the tutorial already stated the
    latter, so the tool now matches. The basics overview also names the base by
    the four printed parts (bottom plate + shoulder mount) instead of the old
    shell wording.
2026-11-06 tutorial: clarify the 6 STL / 4 printed groups mapping in the reference
2026-11-06 tutorial: fix the remaining 01-04 labels and power wording
    The assembly note still called the zero page "06" although it is page 05;
    the basics BOM described the 5 V supply as separate although it feeds the
    ESP32 and servos through the splitter; the environment firmware table now
    reflects the boot-zero centering method.
2026-11-06 tutorial: add the Traditional Chinese translation (zh-hant)
    All 11 pages were converted from zh-hans with OpenCC (s2twp) and then
    normalized (參數/鏡像/即時/重裝, 按 Enter, etc.). Links, section numbers
    and titles pass the same checker as zh-hans/en. tutorial/README and the
    root README now list zh-hant as an available language.
2026-11-06 tutorial: add eight translations and a language switcher
    Adds Japanese, Korean, German, French, Spanish, Italian, Brazilian
    Portuguese and European Portuguese (11 files each), translated from the
    English source. Structure is checked across all 11 languages: files,
    internal links, page numbering, code blocks, inline code, tables,
    headings, lists and paragraph blocks match; no untranslated Chinese
    remains outside the intentional vendor name and language switcher.
    Each index page now has a language switcher, and tutorial/README plus the
    root README list all available languages. Not pushed yet.
